LALLEMANDAlexis/Super-Simon/README.md

# Super-Simon
Projet Arduino sur la création d'un jeu du Simon
