LALLEMANDAlexis/Super-Simon/Rapports séances/Alexis/Séance7-AlexisLallemand.md

Lors de cette séance, j'ai tout d'abord terminé le code des effets sonores du Simon.
J'ai donc repris le code de 4 leds et j'ai rajouté les sons pour la led verte et la led jaune. Ainsi, la partie sonore est maintenant fonctionnelle.(on peut retrouver le code complet du code dans mon fichier de rapport de séance.

Pendant la suite de la séance, l'objectif était de finir la partie extérieure du Simon. En effet, pendant les 3 première séance, j'avais modélisé sur Onshape la pièce qui soutient les boutons mais il manquait encore une pièce en dessous pour que le Simon soit en un bloc, le dessous de la pièce réalisé il y quelques semaines étant ouvert en dessous.
Ainsi, nous profitons aussi de cette pièce à réaliser pour ajouter 3 cm de hauteur pour être certain que le montage électrique puisse tenir à l'intérieur.

Capture d'écran_20230215_112520

Cette pièce garde évidemment la forme de la pièce principale mais a 1mm de largeur et de longueur en plus de chaque côté et également une façade qui suit les contours avec 1mm de moins , ce qui permet à cette pièce de s'emboîter avec l'autre. La pièce fait 5 cm mais a 3cm de hauteur entre chaque facade pour que tout s'embôite avec la hauteur souhaitée.
