LALLEMANDAlexis/Super-Simon/Rapports séances/Martin/Séance6-Martin-Novo.md

Lors de cette séance mon objectif était de réaliser toutes les soudures aux endroits que j'avais indiqué la semaine
dernière. J'ai donc fait 4 soudures par bouton (2 qui servoront à la LED intégrée dans le bouton et 2 autres pour le
bouton en lui-même). C'était vraiment pas facile car les fils étaient vraiment très petit et qu'il fallait à la fois
qu'il y ait contact entre l'embout et le bout du fil mais aussi trouver un point d'équilibre pour pouvoir réaliser
la soudure. Enfin une fois que j'avais fini toutex les soudures sur le temps qu'il me restait j'ai réfléchi à l'endroit
où je brancherai les fils au niveau du montage. Je pense qu'il faudrait remplacer chaque LED par 2 fils au même endroit
et chaque bouton poussoir par 2 fils également ce que je ferai la prochaine séance. Il faudra aussi trouver un moyen de 
fixer chaque bouton au niveau du support puis ensuite d'intégrer le montage en dessous du support avec un espace pour la 
carte arduino. Enfin je me suis rendu compte que l'espace en dessous du support était trop petit pour y intégrer le montage
donc il faudra trouver une solution qui pourrait être de surélever ce support de quelques centimètres. Sinon en ce qui
concerne le programme j'ai décidé de garder le programme de la séance précédente qui fonctionne très bien pour que Alexis
puisse apporter les modifications qu'il souhaite au niveau du son.
Screenshot_20230209-173534_Gallery
