LALLEMANDAlexis/Super-Simon/Rapports séances/Martin/Séance4-Martin-Novo.md

Au début de cette séance je me suis préparé pour l'oral afin d'expliquer au mieux ce que j'ai réalisé pendant 3 séances.
J'ai ainsi pu vérifier que mon programme fonctionnait correctement. Il ne manque plus qu'à ajouter quelques commentaires
et de régler le problème de mauvaise_sequence() qui execute bonne_sequence() que je n'ai toujours pas résolu. Un autre
petit détail c'est que je modifierais surêment bonne_sequence() en y ajoutant à l'intérieur de celle-ci la méthode 
suite_couleur(). J'ai par la suite rajouté dans mauvaise_sequence() et bonne_sequence ce qu'il fallait pour 4 LED donc en
rajoutant les éléments nécessaire pour la LED jaune et la LED verte. Pendant les vacances je pourrais donc finaliser le 
code d'allumage de LED. Après tout cela je me suis penché sur mon prochain objectif qui est celui d'associer ce programme 
au montage éléctrique. J'ai donc regardé notre support 3D qui est arrivé mais aussi essayer de trouver un moyen de relier
le montage que j'ai réalisé pour ensuite faire fonctionner les gros boutons comme les petits boutons poussoirs puisque une 
LED est intégré dans chaque bouton. On remarque aussi en bas des boutons qu'il y a 4 petits bouts, certains qui vont servir 
pour la LED et d'autres pour le bouton. Je suppose que la solution sera donc de souder à ce niveau là par des fils. Je 
réfléchirais à la meilleure solution pendant les vacances pour ensuite l'appliquer à la séance prochaine.
