LALLEMANDAlexis/Super-Simon/Rapports séances/Alexis/Séance2-Alexis-Lallemand.md

Au début de la séance, j'ai réalisé le montage électrique qui servira à tester le fonctionnement du code pour l'activation des LED du Simon.    
Ce montage pourra être utilisé par Martin pour ses premiers tests de LED et la bonne activation de la LED mais il devra ensuite être complété en ajoutant les 3 LED supplémentaires pour savoir si le jeu fonctionne.



Ensuite, j'ai repris la modélisation 3D  de la pièce principale du Simon. Pendant les vacances de Noël, nous avons décidé des pièces que nous allions utiliser, en particulier pour le son et pour le bouton.
Ayant choisi d'utiliser 2 haut-parleurs plutôt qu'un buzzer et d'utiliser des boutons avec une LED de couleur inclus à l'intérieur de ce bouton. 
Les haut-parleurs et les boutons étants circulaires, j' ai donc modifié les formes des compartiments des boutons.

Capture d’écran 2023-01-04 111219

Capture d'écran_20230104_115358

L'idée est également de déposé une plaque de plexiglass translucide au dessus du Simon pour un effet visuel abouti, il est important que le bouton ne dépasse pas de plus de 5mm en hauteur.
J'ai donc adapté la hauteur de la pièce pour qu'elle convienne à la pose du plexigass.
