LALLEMANDAlexis/Super-Simon/Rapports séances/Alexis/Séance1-Alexis-Lallemand.md

Rapport séance 1:

Lors de cette première séance, j'ai effectué un premier montage électrique qui allume une LED afin de prendre les mesures d'un bloc LED-bouton poussoir-résistance.
Notre Simon étant rectangulaire, un bloc LED-bouton-résistance pour cacher le montage électrique du jeu sera lui aussi un rectangle.
Je suis ensuite passé sur Onshape pour modéliser les pièces du Simon qui devront être imprimé en 3D.

Voici la modélisation 3D d'un bloc dans lequel on disposera une LED de couleur et le bouton associé à cette couleur.Les deux perçages réalisés serviront à avoir un accès au bouton et également à pouvoir voir si la LED s'allume. 

Capture d’écran 2022-12-14 120915

Voici maintenant la modélisation 3D de la pièce latérale du Simon. Dans chaque rectangle sera disposé un bloc LED-bouton.
Le perçage circulaire est réservé au haut-parleur, sa place n'est pas encore déterminé et sera peut-être modifié lors de la deuxième séance.

Capture d’écran 2022-12-14 123306
