LALLEMANDAlexis/Super-Simon/Rapports séances/Alexis/Séance8-AlexisLallemand.md

Séance 8:

Lors de cette séance, j'ai commencé par mettre à imprimer la pièce réalisé pour ajouter la hauteur nécessaire au montage électrique.
Ensuite, la séance a été axé sur les derniers tests réalisé pour vérifier que le Simon fonctionne et qu'il n'y ait pas de problèmes. 
Il y avait effectivement certains problèmes à régler: tout d'abord le bouton vert ne s'allumait que par intermittences à cause de certains fils électriques qui ne restait pas
fixé à la plaque, ainsi nous avons changé ces fils.
De plus, le son sortant du haut parleur était très faible en sortie du haut parleur et il a fallu enlever la résistance pour la remplacer par un potentiomètre 10k ohms.
Celui-ci ne sera pas visible ni atteignable en pleine partie donc le son ne pourra être modifiable que en soulevant la pièce principale mais il a permis d'avoir un son audible
par rapport au début de la séance.(voir photo pour le montage)



De plus, certaines modifications ont été faites au niveau du code son en adéquation au nouveau code led de Martin et tous les effets sonores sont fonctionnels.

Enfin, avant la soutenance, nous allons faire le montage final, c'est à dire mettre le montage électrique à l'intérieur des pièces imprimées en 3D, ce qui devrait signer la fin de notre projet.
