LALLEMANDAlexis/Super-Simon/Rapports séances/Martin/Séance7-Martin-Novo.md

Durant cette séance j'ai fait le test de mes 4 boutons en mettant en pratique l'idée que j'avais suggéré la semaine
dernière c'est à dire de brancher les fils qui ont été soudé à la place de chacune des LED et de chacun des boutons
poussoirs. J'ai observé le résultat et pour l'instant il n'y a qu'un seul bouton qui s'allume c'est le vert et les
autres par contre ne s'allument pas. J'ai donc commencé à chercher une explication et j'ai constaté que mes soudures
au niveau du bouton vert étaient mieux réalisées que sur les autres boutons où j'ai pu voir que une soudure sur les 
4 était vraiment pas bien faites et où il n'y a pas forcement de contact entre l'embout et le fil. J'ai donc essayé
de refaire certaines de mes soudures mais les 3 autres boutons ne marchent toujours pas donc ce qu'il me reste à faire
c'est pendant les vacances de repasser par dessus les moins bonnes soudures et d'ensuite tester si chaque bouton 
fonctionne et il ne me restera plus qu'à placer chaque bouton sur le support et y placer également le montage et 
la carte arduino en dessous. De plus, pour éviter que rien ne se passe à la fin d'une partie au niveau du programme
j'ai rajouté "LVL = 1" pour que l'on puisse recommencer une partie sans avoir à réappuyer sur un bouton pour refaire
une partie. Enfin il faudra fixer chaque bouton et revérifier les derniers détails.
