LALLEMANDAlexis/Super-Simon/Rapports séances/Alexis/Séance3-AlexisLallemand.md

Au début de cette séance, j'ai imprimé la pièce réalisé sur Onshape pendant les deux premières séances qui servira à cacher le montage électrique.
La dernière problématique sur la pièce était que celle-ci était décomposé en trois parties sur Onshape, j'ai donc du reprendre remodéliser une partie de cette pièce pour avoir une seule partie.
Une fois la remodélisation effectuée, la pièce a été mise à imprimer.

Ensuite, j'ai récupérer les 4 bouton lumineux qui serviront à afficher la séquence lumineuse puis à la reconstituer par le joueur.
J'ai assemblé ces boutons qui venaient en pièces détachées. Une fois assemblé, celui-ci ressemble à ça:



En fin de séance, nous avons reçu le montage du haut-parleur qui me servira à la prochaine séance pour commencer le code du son du Simon.
