LALLEMANDAlexis/Super-Simon/soutenance projet1.pdf

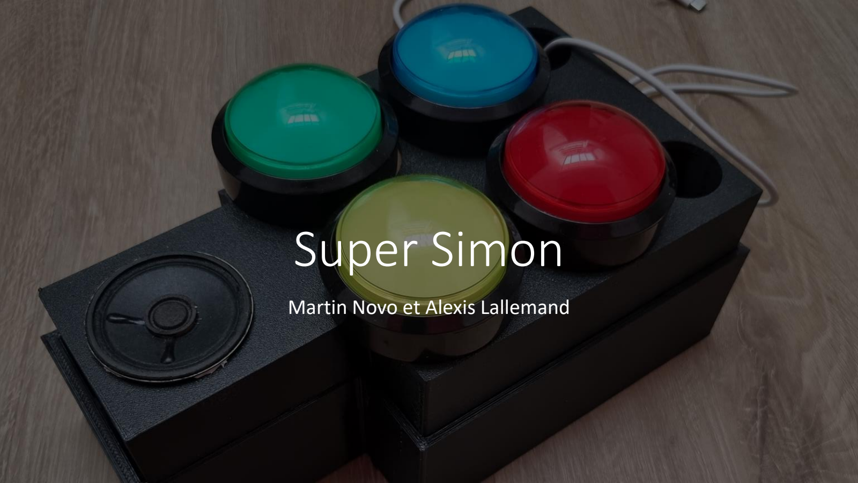
[picture p3: page 1]

# Super Simon

Martin Novo et Alexis Lallemand

## Sommaire

- Slide 3-4: Pourquoi ce projet?, Objectif et Problématique
- Slide 5: Utilisation du matériel
- Slide 6-10:Fonctions et montage électrique
- Slide 11: Modélisation et son
- Slide 12: Planning
- Slide 13: Démonstration et Conclusion

## Pourquoi un Simon?

- Permet d'améliorer sa mémoire
- Jeu que nous apprécions tous les deux
- Allie code et montage

## Objectif et Problématique

- 4 couleurs
- Effet visuel lumineux
- Effet sonore
- Un ajout de une couleur par niveau
- Le jeu peut-être relancé après une victoire comme une défaite

## Le matériel

- 4 boutons de couleur avec LED intégrées
- Résistances
- Haut-parleur
- Potentiomètre
- Carte Arduino Uno
- Imprimante 3D
- Fer à souder

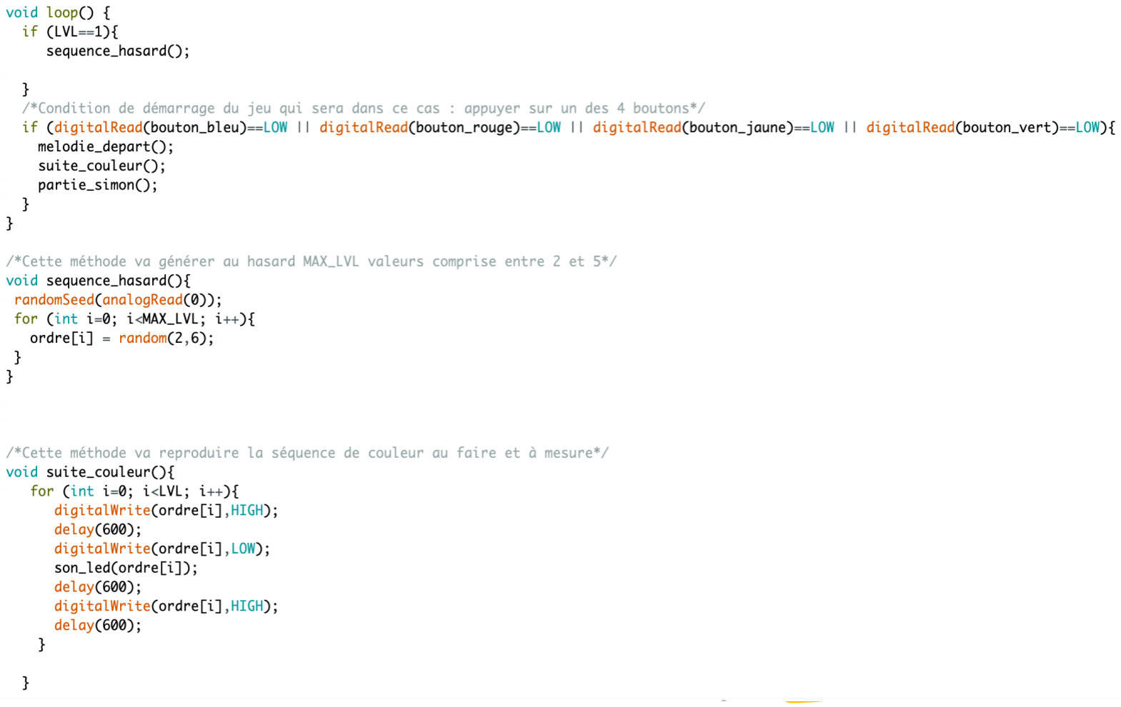
[picture p4: figure]

## Fonctions et montage

- Méthode sequence_hasard()
- Conditions de démarrage d'une partie
- Méthode suite_couleur()

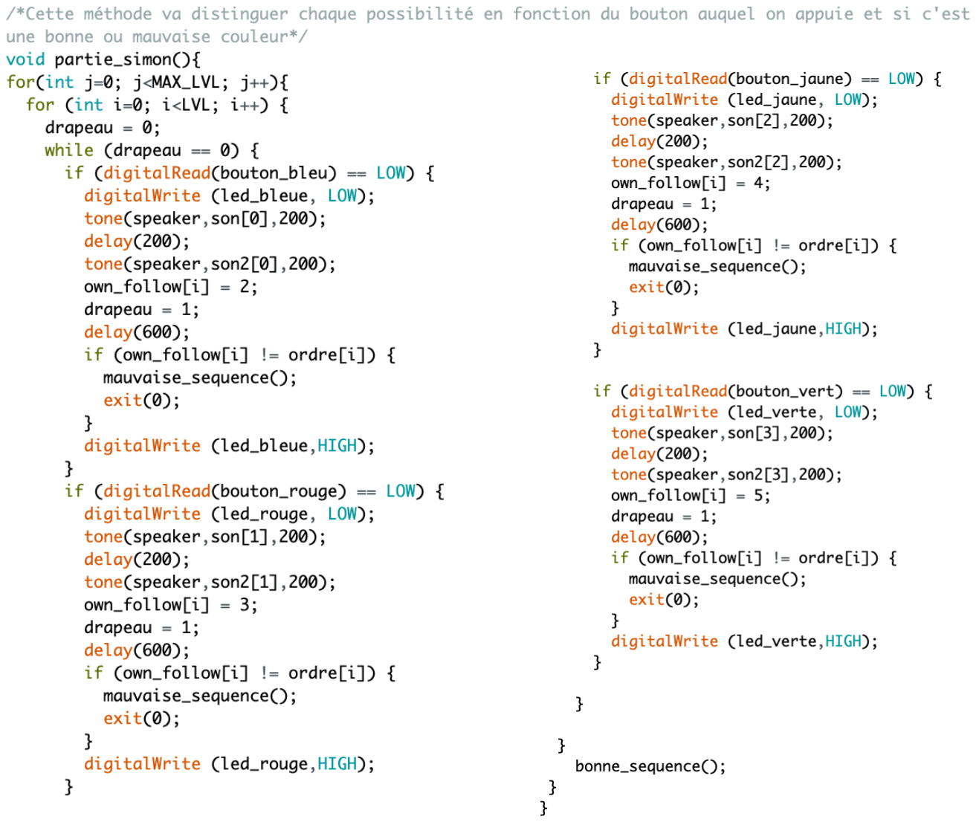
[picture p5: figure]

## Fonctions et montage

- Méthode partie_simon()

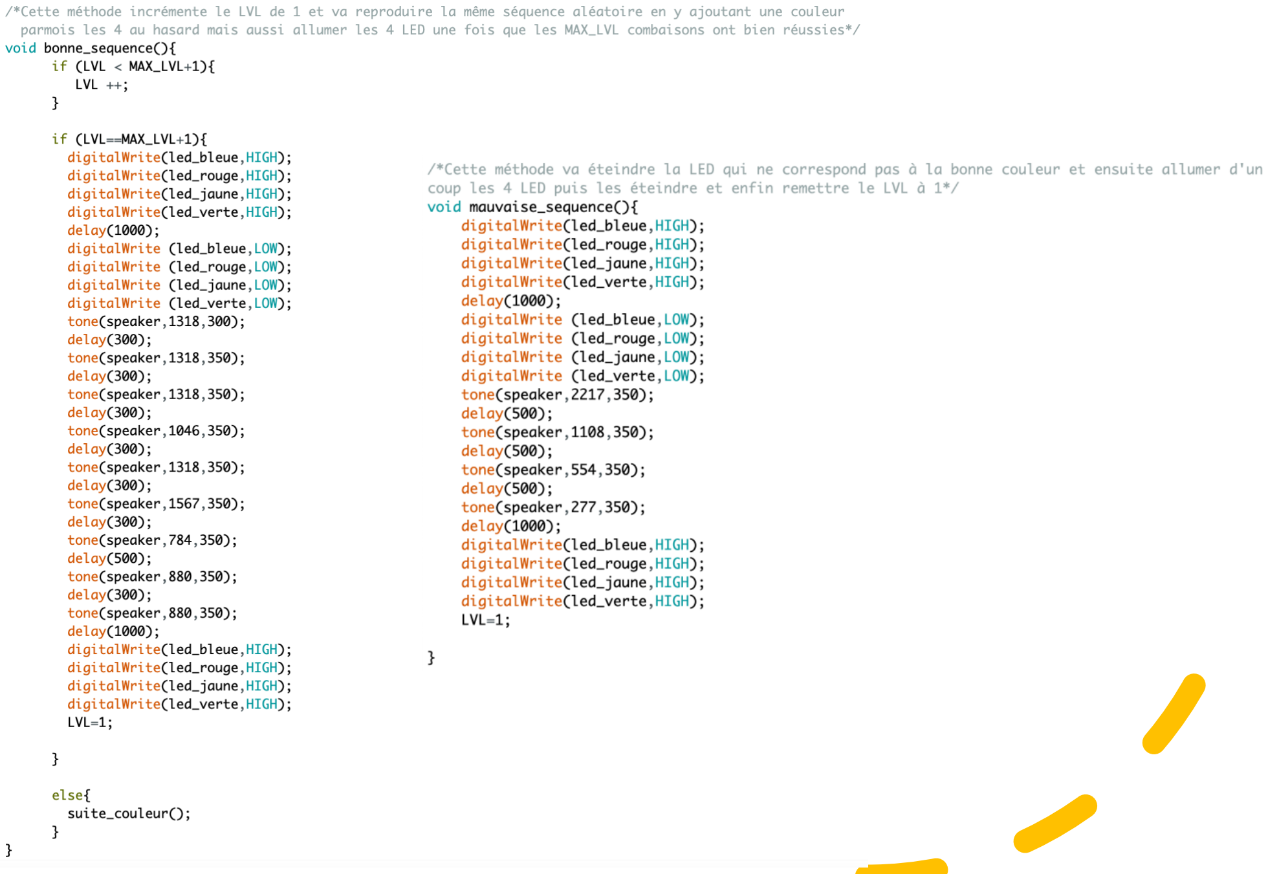
[picture p6: figure]

## Fonctions et montage

- Méthode bonne_sequence()
- Méthode mauvaise_sequence()

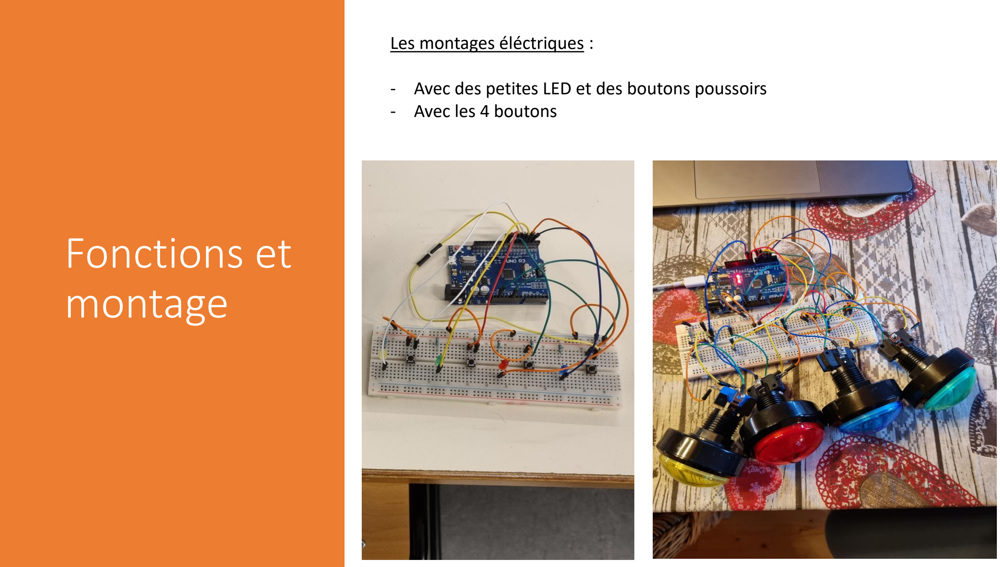
[picture p7: page 9]

## Fonctions et montage

Les montages éléctriques :

- Avec des petites LED et des boutons poussoirs
- Avec les 4 boutons

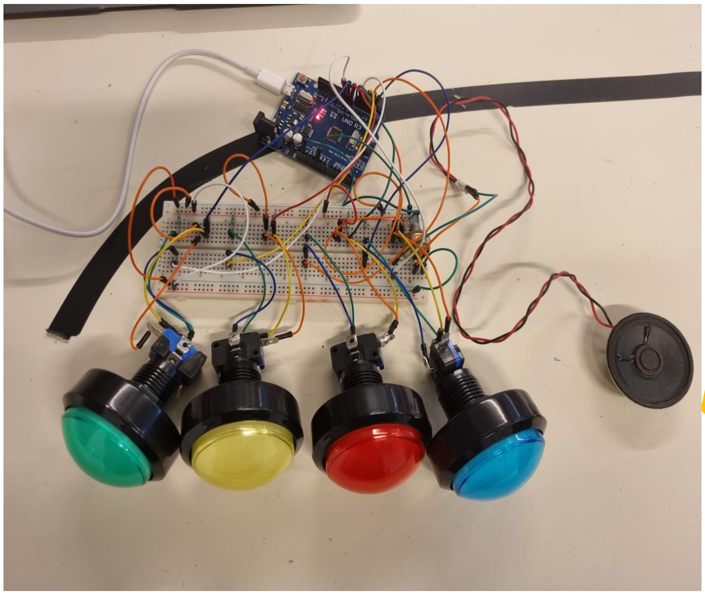
[picture p8: figure]

## Fonctions et montage

Le montage final

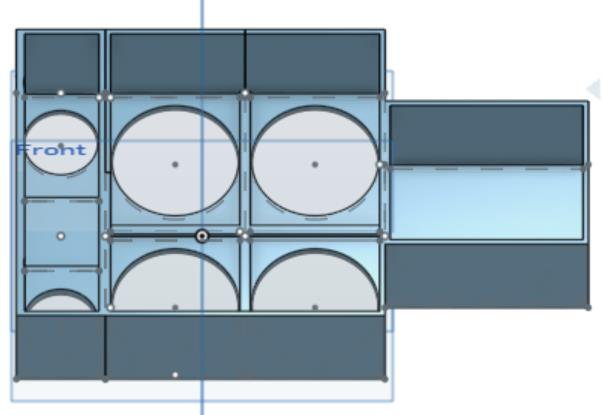
[picture p9: figure]

## Modélisation et son

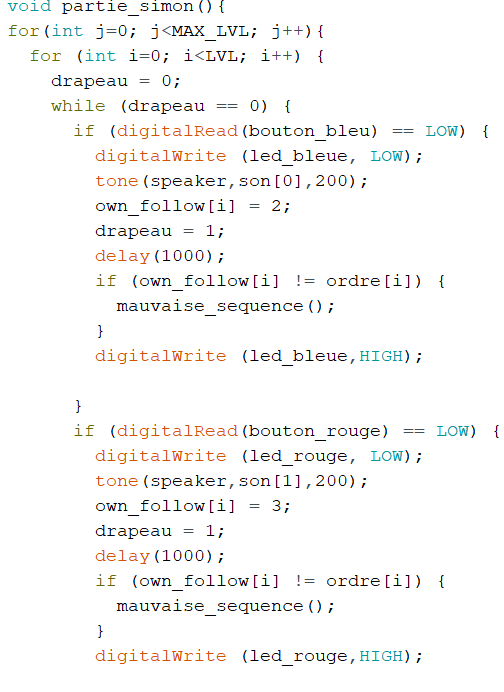
[picture p10: figure]

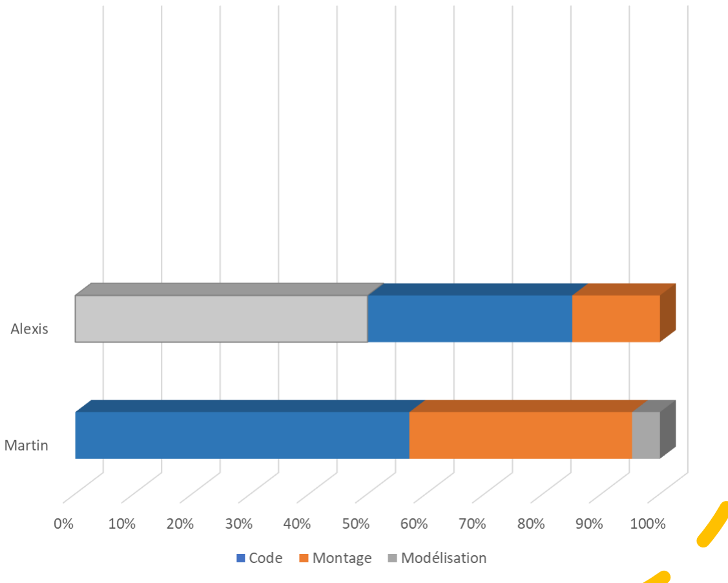
[picture p11: figure]

## Planning

## Conclusion

- Projet instructif
- Plus de complications qu’anticipées
- Confiance l’un en l’autre importante pour réussir
- Plaisir à réaliser
