LALLEMANDAlexis/Super-Simon/(commit log)

2022-12-13 Create Cahier des charges et emploi du temps
2022-12-13 Update Cahier des charges et emploi du temps
